mjf028/scoreboard-pages/site-assets/adresuno-5v-power-supply.webp

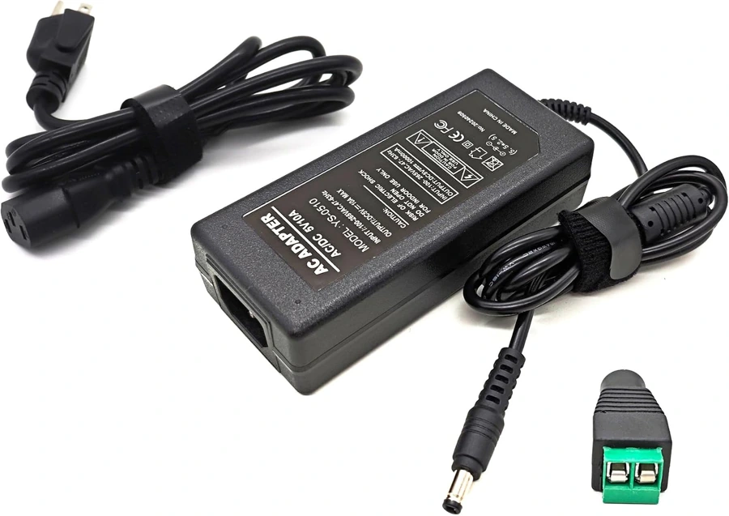
site-assets/adresuno-5v-power-supply.webp
