mjf028/scoreboard-pages/site-assets/alibaba-p2-led-panel.jpg

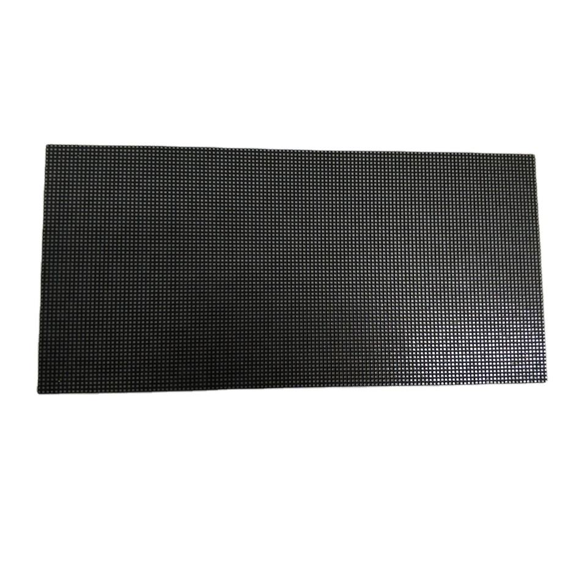
site-assets/alibaba-p2-led-panel.jpg
