mjf028/scoreboard-pages/site-assets/dap-weldwood-contact-cement.webp

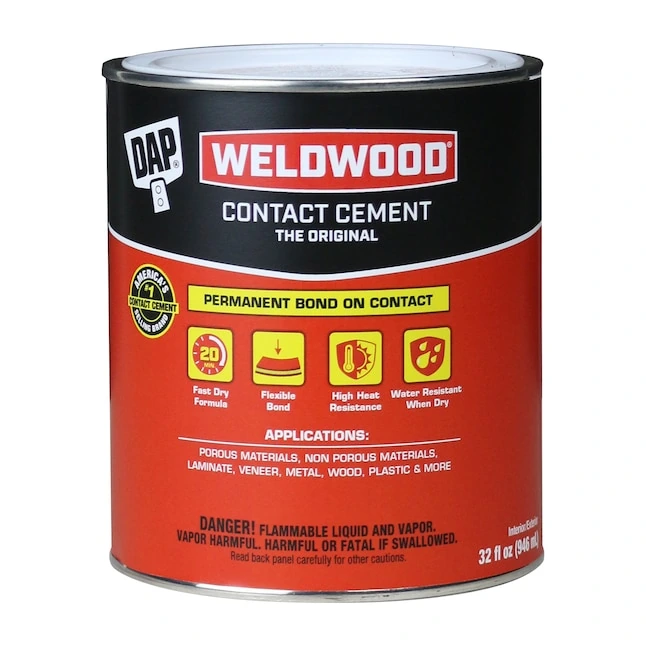
site-assets/dap-weldwood-contact-cement.webp
