mjf028/scoreboard-pages/site-assets/elegoo-dupont-jumper-wires.jpg

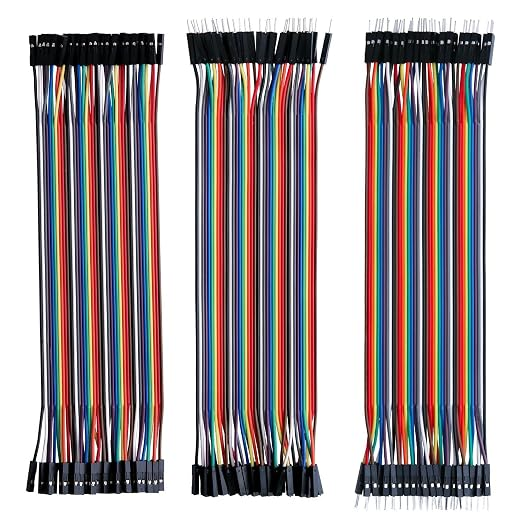
site-assets/elegoo-dupont-jumper-wires.jpg
