mjf028/scoreboard-pages/site-assets/filn-momentary-buttons.webp

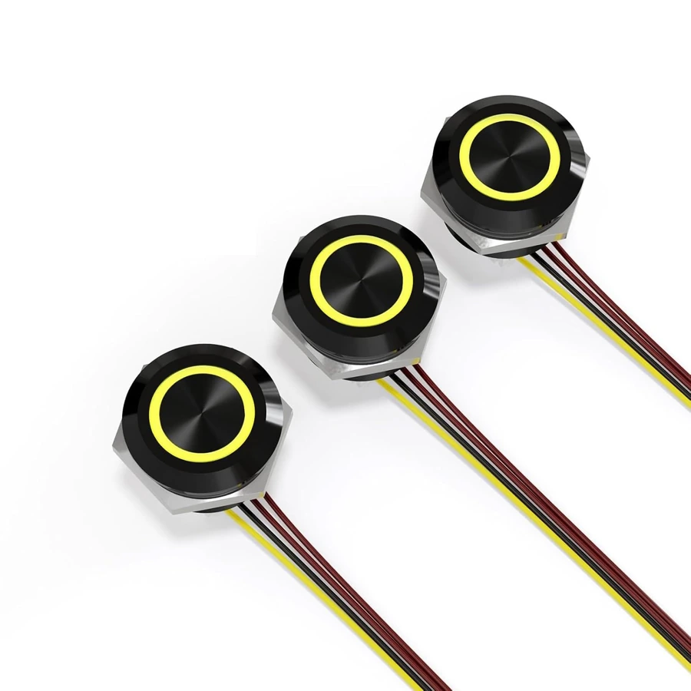
site-assets/filn-momentary-buttons.webp
