mjf028/scoreboard-pages/site-assets/llidgermal-hub75-adapter.webp

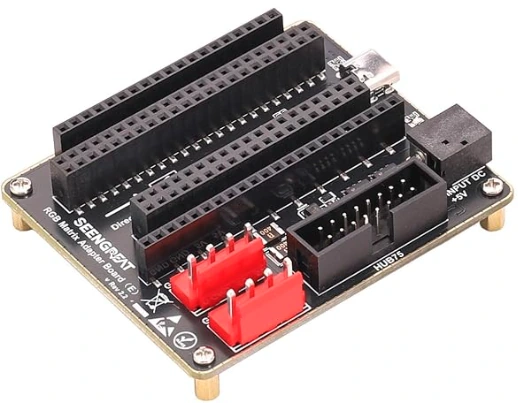
site-assets/llidgermal-hub75-adapter.webp
