mjf028/scoreboard-pages/site-assets/lonely-binary-esp32-s3.webp

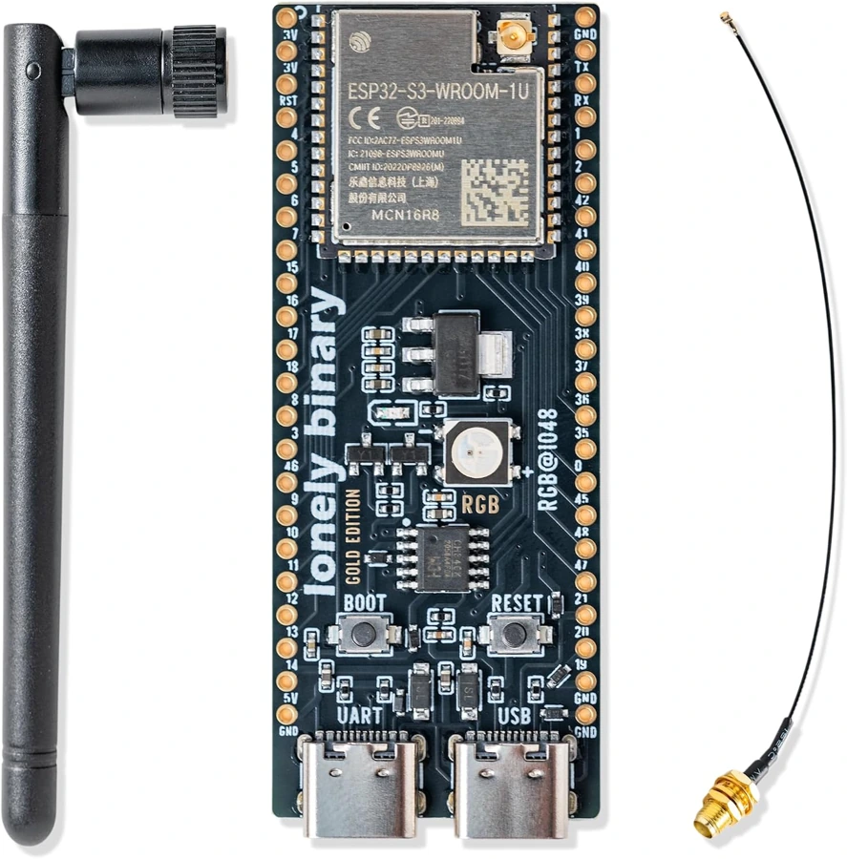
site-assets/lonely-binary-esp32-s3.webp
