mjf028/scoreboard-pages/site-assets/mojotone-smooth-brown-tolex.webp

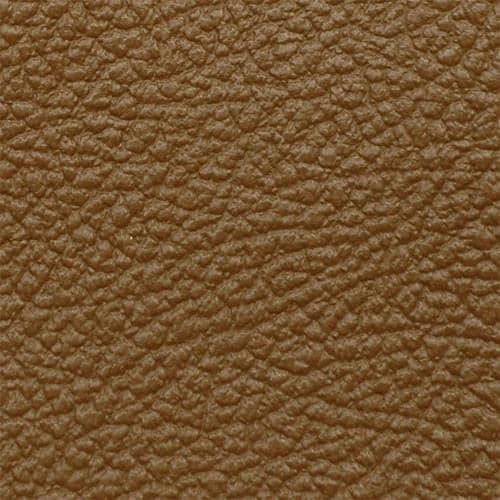
site-assets/mojotone-smooth-brown-tolex.webp
