mjf028/scoreboard-pages/site-assets/poyiccot-panel-usbc.webp

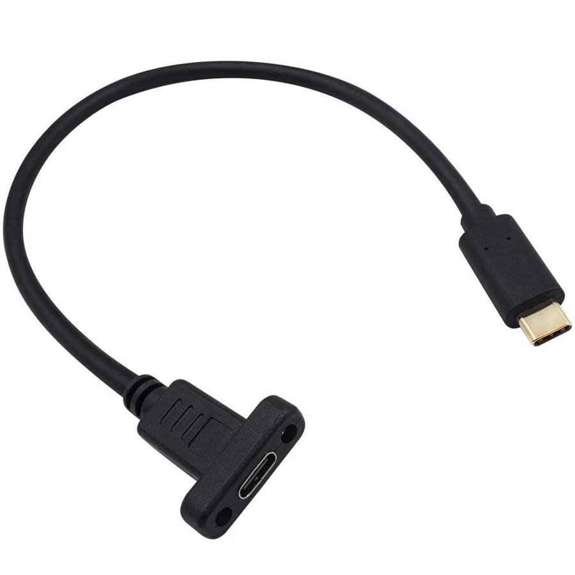
site-assets/poyiccot-panel-usbc.webp
