mjf028/scoreboard-pages/site-assets/scoreboard-powered.webp

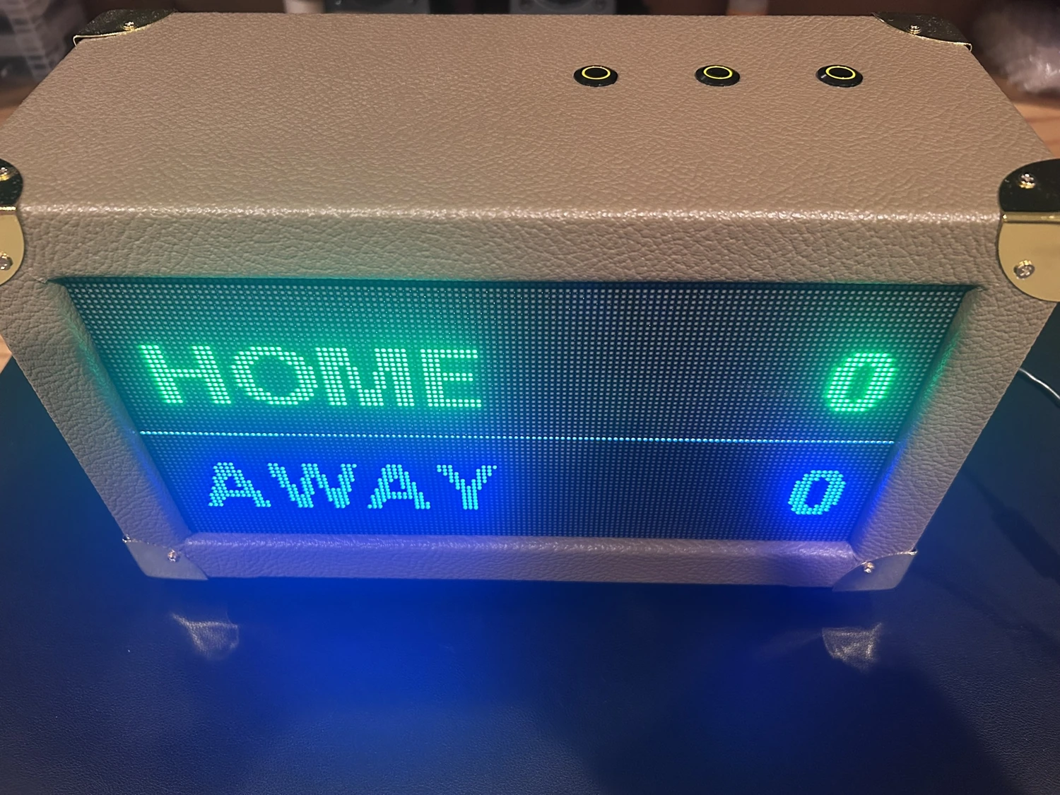
site-assets/scoreboard-powered.webp
