mjf028/scoreboard-pages/site-assets/scoreboard-rear.webp

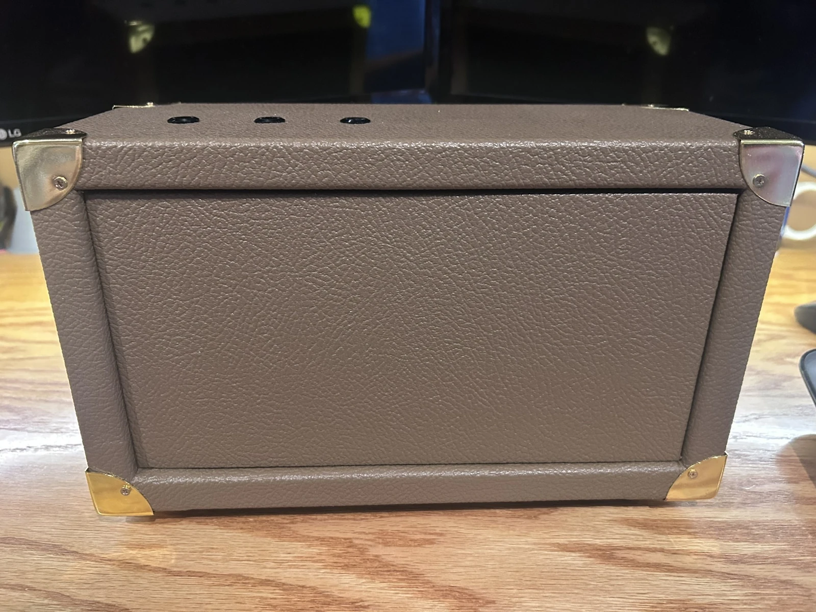
site-assets/scoreboard-rear.webp
