mjf028/scoreboard-pages/site-assets/sdtc-dc-jack-kit.webp

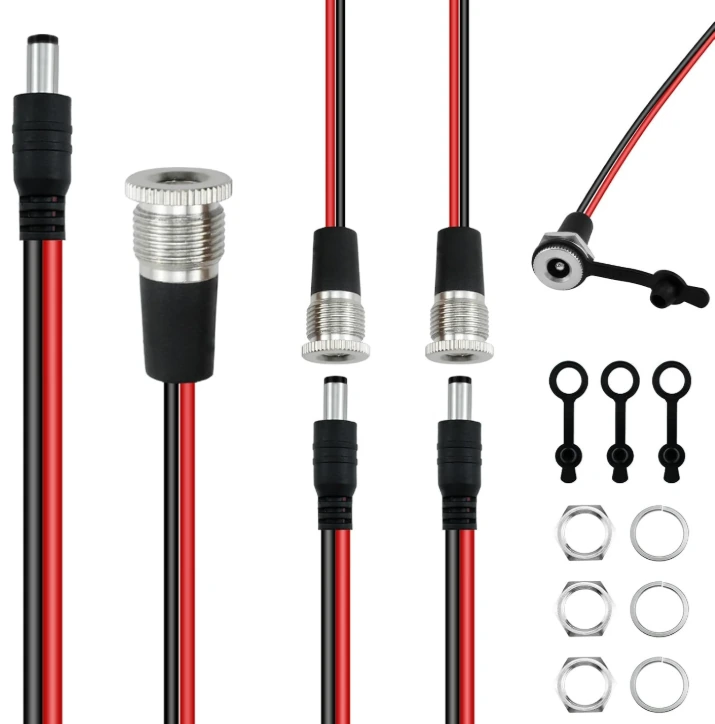
site-assets/sdtc-dc-jack-kit.webp
