mjf028/scoreboard-pages/site-assets/uxcell-corner-protectors.webp

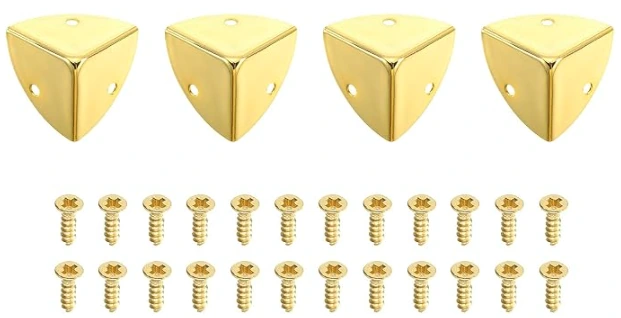
site-assets/uxcell-corner-protectors.webp
