mjf028/scoreboard-pages/wiring.html

Skip to content

▪▪
▪▪SCOREBOARD GitHub ↗ (https://github.com/mjf028/scoreboard-pages)

Wiring diagrams

# Wire it on the bench.

Use these diagrams with the panel and controller in the parts guide. Disconnect power while changing any connections.

## 5 V power and service access

The 5 V adapter feeds the panel-mount DC jack and the HUB75 adapter. The controller and panel share a common ground. Use the panel-mount USB-C extension for programming and service.

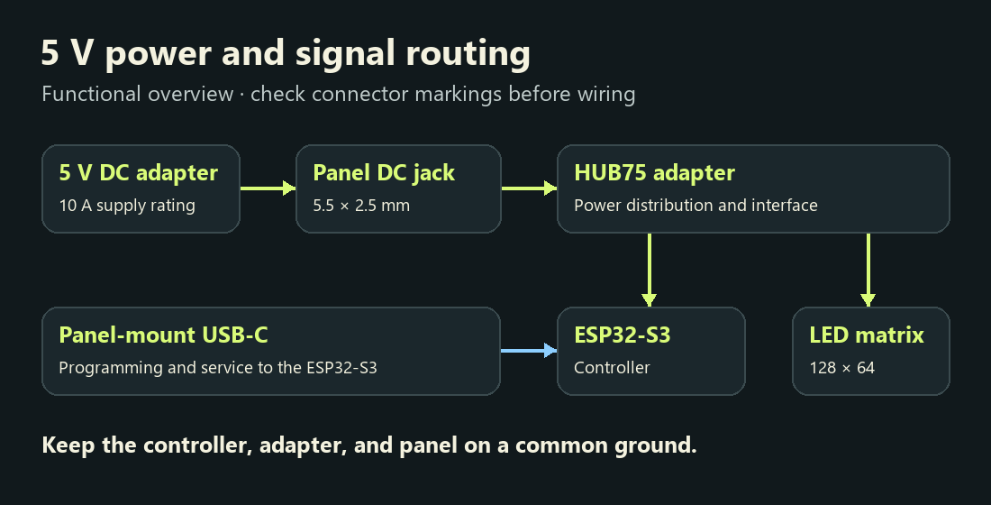
[picture p16: site-assets/power-routing.png]
Power flows from the 5 V adapter through the DC jack to the HUB75 adapter, which interfaces with the controller and matrix. USB-C connects separately to the controller.


Download power diagram ↓

## Three active-low buttons

Wire each normally open switch between its GPIO and ground. Firmware enables internal pull-ups. Illuminated switches use a separate 5 V and ground circuit for their lamps. Verify the lamp rating and terminals for your exact buttons.

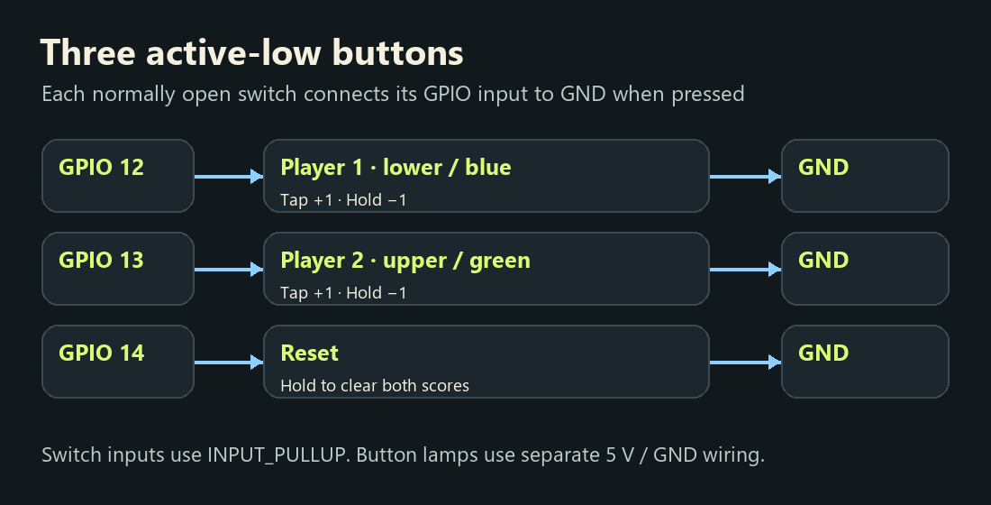
[picture p17: site-assets/button-wiring.png]
Player 1 closes GPIO 12 to ground, Player 2 closes GPIO 13 to ground, and Reset closes GPIO 14 to ground.


Download button diagram ↓

Control | GPIO | Short release | Hold ≥600 ms
Player 1 · blue | 12 | +1 | −1
Player 2 · green | 13 | +1 | −1
Reset | 14 | No change | Clear both

See the button and harness photos

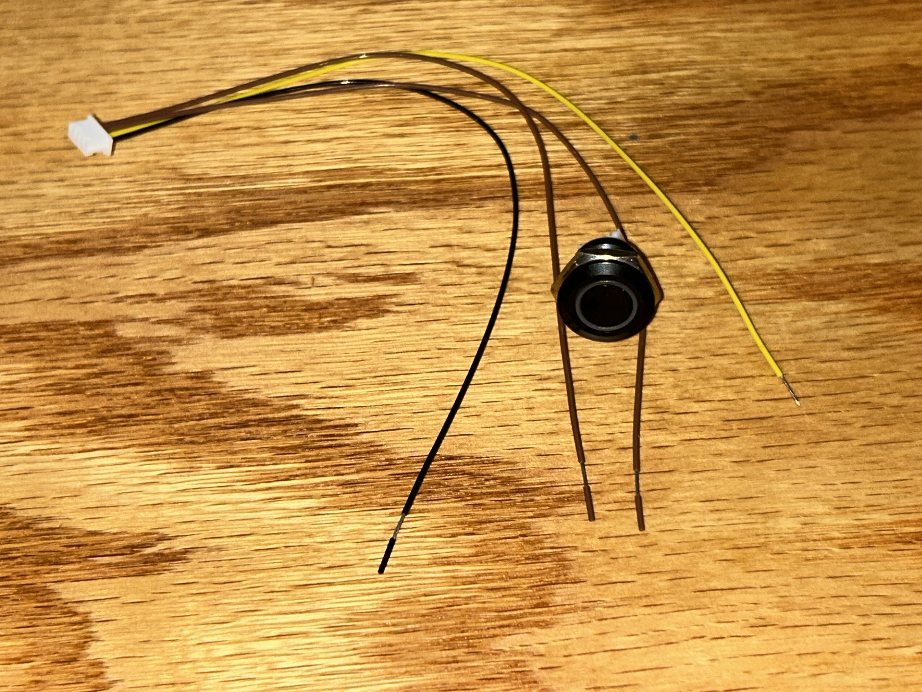
[picture p18: docs/images/button.png]
Momentary switch with its wiring leads
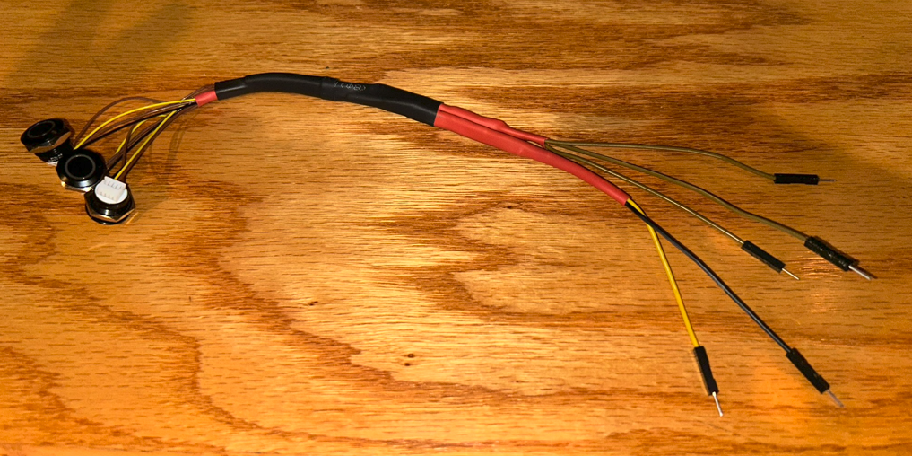
[picture p19: docs/images/button_harness.png]
Three momentary switches with their wiring harness
 

## HUB75E signal map

Match signal labels to the GPIO assignments in the sketch. The E address line is required for the documented 64-pixel-high, 1/32-scan panel.

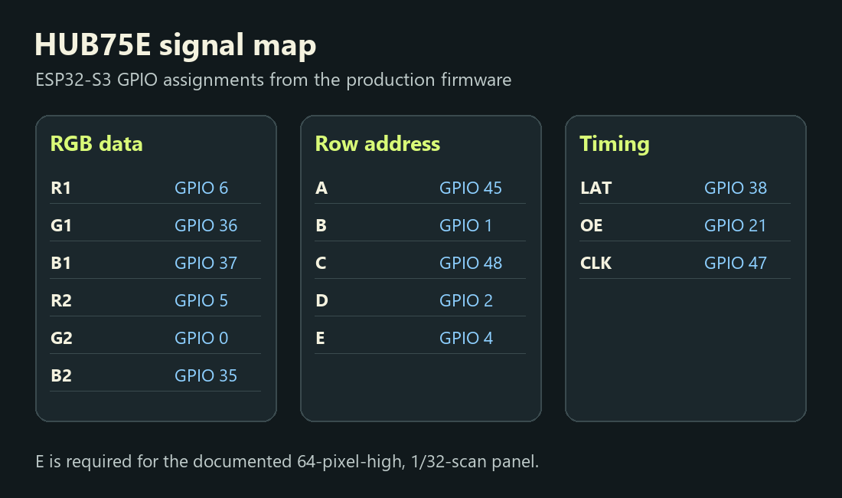
[picture p20: site-assets/hub75-signal-map.png]
HUB75E signals grouped into RGB data, row address, and timing. All GPIO assignments are listed in the table below.


Download pin map ↓

HUB75E signal | ESP32-S3 GPIO
R1 | 6
G1 | 36
B1 | 37
R2 | 5
G2 | 0
B2 | 35
A | 45
B | 1
C | 48
D | 2
E | 4
LAT | 38
OE | 21
CLK | 47

See the reference ESP32-S3 pinout

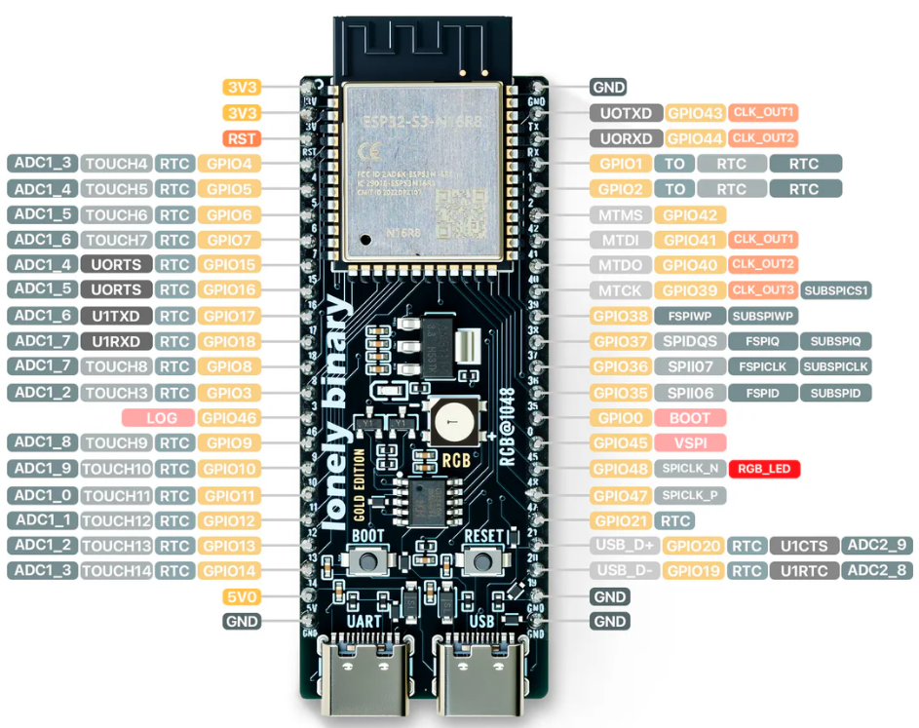
[picture p21: docs/images/gpio_layout.png]
ESP32-S3 development board pinout reference with labeled GPIO pins


## Inside the finished cabinet

Compare the photos with the power diagram and signal map. The HUB75 ribbon cable and panel power cable came with the LED panel. The close-ups show where the adapter is mounted and how the ribbon and power leads reach the back of the panel.

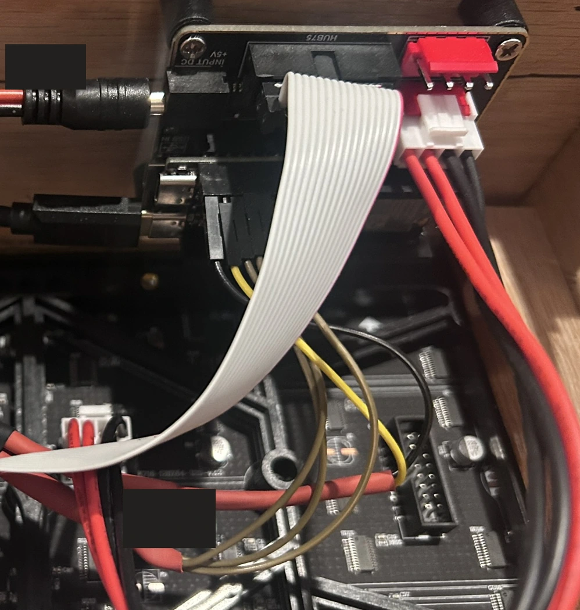
[picture p22: site-assets/adapter-installed.webp]
Installed HUB75 adapter with the DC input, red power connector, and flat ribbon cable


HUB75 adapter mounted inside the cabinet

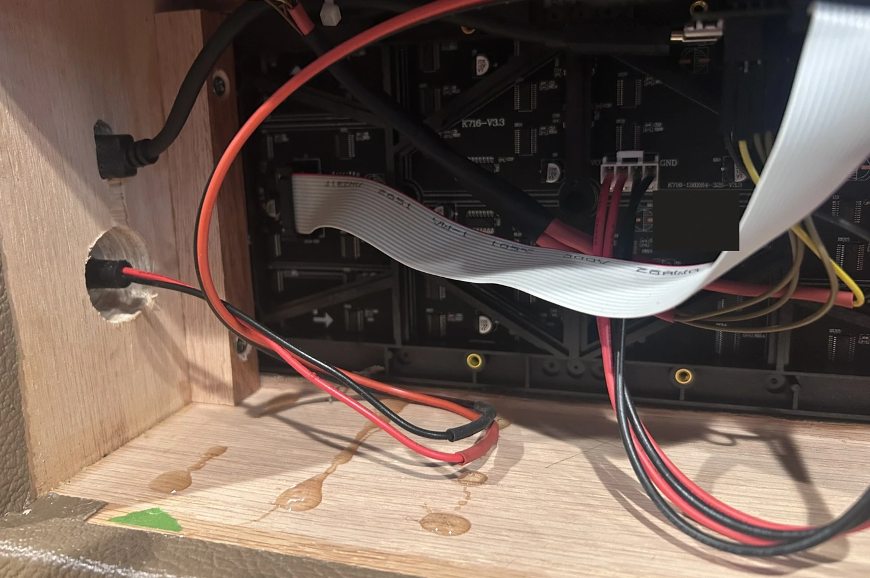
[picture p23: site-assets/panel-wiring-installed.webp]
Matrix rear showing the flat HUB75 ribbon, power leads, and side-wall connections


Ribbon and power leads at the matrix

See the cabinet and side ports ↗

## Before power-on

- Confirm the adapter, panel, and lamp voltage ratings and verify polarity at each connector.
- Size the wire and connectors for the panel current. Use the documented external 5 V supply for the panel.
- Check ground continuity and ribbon orientation. Disconnect power before moving the HUB75 ribbon.

Continue to firmware ↗

▪▪
▪▪SCOREBOARDView source on GitHub ↗ (https://github.com/mjf028/scoreboard-pages)
