mjf028/scoreboard-pages/(commit log)

2026-11-11 Feature ESP32-S3 and restore original scoreboard photos
2026-11-11 Add component photos and confirmed LED panel pricing
2026-11-11 Show the finished wiring and document the P1.53 prototype
2026-11-11 Add Weldwood contact cement to the build BOM
2026-11-11 Identify exact Lonely Binary controller and FILN button set
2026-11-12 Link the exact Alibaba production LED panel
2026-11-13 Add Alibaba LED panel photo to the BOM
2026-11-13 Remove prototype cost note from the BOM page
2026-11-13 Link BOM prices and update FILN button estimate
2026-11-13 Clarify bundled panel cables and wiring supplies
2026-11-13 Document cabinet materials and actual build cost
2026-11-13 Add ELEGOO jumper wire kit to parts list
